Zhopper/bayan_mega/(list of files, drawings)

Other design files:
sch/midi_generator_v1.0.0.pcb
