Zhopper/bayan_mega/soft/Midi_Bayan_Mega/a_Small_Rus.c

#if defined(__AVR__)
  #include <avr/pgmspace.h>
  #define fontdatatype const uint8_t
#elif defined(__PIC32MX__)
  #define PROGMEM
  #define fontdatatype const unsigned char
#elif defined(__arm__)
  #define PROGMEM
  #define fontdatatype const unsigned char
#endif

// New font 177 symbols 5x8 = 885+4 bytes

fontdatatype SmallFont[] PROGMEM =
{
0x05, 0x08, 0x20, 0xb1,
0x00, 0x00, 0x00, 0x00, 0x00,   // sp
0x00, 0x00, 0x2f, 0x00, 0x00,   // !
0x00, 0x07, 0x00, 0x07, 0x00,   // "
0x14, 0x7f, 0x14, 0x7f, 0x14,   // #
0x24, 0x2a, 0x7f, 0x2a, 0x12,   // $
0x23, 0x13, 0x08, 0x64, 0x62,   // %
0x36, 0x49, 0x55, 0x22, 0x50,   // &
0x00, 0x05, 0x03, 0x00, 0x00,   // '
0x00, 0x1c, 0x22, 0x41, 0x00,   // (
0x00, 0x41, 0x22, 0x1c, 0x00,   // )
0x14, 0x08, 0x3E, 0x08, 0x14,   // *
0x08, 0x08, 0x3E, 0x08, 0x08,   // +
0x00, 0x00, 0xA0, 0x60, 0x00,   // ,
0x08, 0x08, 0x08, 0x08, 0x08,   // -
0x00, 0x60, 0x60, 0x00, 0x00,   // .
0x20, 0x10, 0x08, 0x04, 0x02,   // /

0x3E, 0x51, 0x49, 0x45, 0x3E,   // 0
0x00, 0x42, 0x7F, 0x40, 0x00,   // 1
0x42, 0x61, 0x51, 0x49, 0x46,   // 2
0x21, 0x41, 0x45, 0x4B, 0x31,   // 3
0x18, 0x14, 0x12, 0x7F, 0x10,   // 4
0x27, 0x45, 0x45, 0x45, 0x39,   // 5
0x3C, 0x4A, 0x49, 0x49, 0x30,   // 6
0x01, 0x71, 0x09, 0x05, 0x03,   // 7
0x36, 0x49, 0x49, 0x49, 0x36,   // 8
0x06, 0x49, 0x49, 0x29, 0x1E,   // 9
0x00, 0x36, 0x36, 0x00, 0x00,   // :
0x00, 0x56, 0x36, 0x00, 0x00,   // ;
0x08, 0x14, 0x22, 0x41, 0x00,   // <
0x14, 0x14, 0x14, 0x14, 0x14,   // =
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
0x7C, 0x04, 0x04, 0x02, 0x00,   //B4    180   ґ   D2 91
0x00, 0x4A, 0x55, 0x29, 0x00,   //A7    167   §   C2 A7
0x00, 0x06, 0x09, 0x09, 0x06,   //            °   C2 B0
0x44, 0x44, 0x5F, 0x44, 0x44,   //B1    177   ±   C2 B1

0x7C, 0x10, 0x10, 0x3C, 0x40,   //B5    181   µ   C2 B5
};
